laullon/anden-dcc/hardware/pico2w-reva/datasheets/README.md

# EXPERIMENT · local datasheet PDFs

English-language references only. The CH224 v1F English copy is retained;
a later Chinese revision is not included.

Downloaded 12 November 2026 for this experimental design. Documents retain
their original publishers' ownership and notices; the repository MIT license
does not relicense these PDFs. These are reference snapshots, not proof that
the candidate components or footprints are approved.

| PDF | Acquisition source |
| --- | --- |
| [Pico-2-W.pdf](Pico-2-W.pdf) | https://datasheets.raspberrypi.com/picow/pico-2-w-datasheet.pdf |
| [DRV8874.pdf](DRV8874.pdf) | https://www.ti.com/lit/ds/symlink/drv8874.pdf |
| [LMR51420.pdf](LMR51420.pdf) | https://www.ti.com/lit/ds/symlink/lmr51420.pdf |
| [CH224-v1F-EN.pdf](CH224-v1F-EN.pdf) | https://www.laskakit.cz/user/related_files/ch224ds1.pdf |
| [TPS3435.pdf](TPS3435.pdf) | https://www.ti.com/lit/ds/symlink/tps3435.pdf |
| [SN74LVC1G08.pdf](SN74LVC1G08.pdf) | https://www.ti.com/lit/ds/symlink/sn74lvc1g08.pdf |
| [PCA9306.pdf](PCA9306.pdf) | https://www.ti.com/lit/ds/symlink/pca9306.pdf |
| [USB4750-drawing.pdf](USB4750-drawing.pdf) | https://gct.co/files/drawings/usb4750.pdf |
| [TPS2663.pdf](TPS2663.pdf) | https://www.ti.com/lit/ds/symlink/tps2663.pdf |
| [SB560.pdf](SB560.pdf) | https://www.vishay.com/docs/88721/sb520.pdf |
| [1N5819.pdf](1N5819.pdf) | https://www.vishay.com/docs/88525/1n5817.pdf |

U1's KiCad Datasheet property uses `${KIPRJMOD}/../datasheets/CH224-v1F-EN.pdf`.
The schematic note names the same relative PDF. Open the `.kicad_pro` project
so KiCad resolves the project path. The review notes above link directly to files.
