laullon/anden-dcc/hardware/pico2w-reva/pinmap.csv

project_status | gpio | physical_pin | signal | direction | notes
EXPERIMENT_DESIGN_ONLY | 2 | 4 | DCC_PH | Output | PIO DCC waveform to DRV8874 PH
EXPERIMENT_DESIGN_ONLY | 3 | 5 | TRACK_EN_REQUEST | Output | PIO-aligned request through external watchdog gate
EXPERIMENT_DESIGN_ONLY | 4 | 6 | OLED_SDA | Bidirectional | I2C0. 3.3 V side of any required translator
EXPERIMENT_DESIGN_ONLY | 5 | 7 | OLED_SCL | Output | I2C0. 3.3 V side of any required translator
EXPERIMENT_DESIGN_ONLY | 6 | 9 | ENC_A | Input pull-up | Encoder contact to GND
EXPERIMENT_DESIGN_ONLY | 7 | 10 | ENC_B | Input pull-up | Encoder contact to GND
EXPERIMENT_DESIGN_ONLY | 8 | 11 | SELECT_N | Input pull-up | Encoder push button to GND
EXPERIMENT_DESIGN_ONLY | 9 | 12 | STOP_N | Input pull-up | Movement stop button to GND
EXPERIMENT_DESIGN_ONLY | 10 | 14 | MOVEMENT_LED | Output | Series resistor and LED to GND
EXPERIMENT_DESIGN_ONLY | 11 | 15 | DRIVER_FAULT_N | Input | 3.3 V pull-up on open-drain driver fault
EXPERIMENT_DESIGN_ONLY | 12 | 16 | WATCHDOG_HEARTBEAT | Output | Pulse only after application and DCC health checks
EXPERIMENT_DESIGN_ONLY | 13 | 17 | PD_PG_N | Input | 3.3 V pull-up on active-low PD PG
EXPERIMENT_DESIGN_ONLY | 14 | 19 | DRIVER_WAKE | Output | Driver nSLEEP with default-off pull-down
EXPERIMENT_DESIGN_ONLY | 15 | 20 | WATCHDOG_CONTROL | Output | Enable/re-arm semantics depend on final watchdog variant
EXPERIMENT_DESIGN_ONLY | 26 | 31 | RAIL_SENSE | ADC input | Divider filter and clamp values pending
EXPERIMENT_DESIGN_ONLY | 27 | 32 | CURRENT_SENSE | ADC input | Filtered protected IPROPI sense voltage
