laullon/anden-dcc/docs/hardware/connections.csv

source | destination | purpose
Uno USB | Uno and shield 5V logic | Bench or upload only; disconnect cab external 5 V first
PD +15V | MP1584 IN+ | Cab board step-down input
PD GND | MP1584 IN- | Common ground
MP1584 OUT+ 5.0V | ESP13 Arduino-side 5V header and OLED VCC | Verified regulated logic supply; disconnect before Uno USB
MP1584 OUT- | ESP13 Arduino-side GND header and OLED GND | Common ground
Uno D4 | Encoder A | Rotary input
Uno D5 | Encoder B | Rotary input
Uno D6 | Encoder switch contact | Select next on-diorama loco
Uno D2 | STOP switch contact | Stop movement
Uno GND | Encoder common and switch returns and STOP return | Contacts close to ground
Uno D7 | 470 ohm resistor then LED anode | Commanded movement indicator; LED cathode to GND
Uno A4 | OLED SDA | I2C data
Uno A5 | OLED SCL | I2C clock
PD +15V | Motor shield VIN terminal | Motor power; VIN CONNECT open
PD GND | Motor shield GND | Common ground
ESP13 TX via shield | Uno D0 RX | Checked UART request
Uno D1 TX | ESP13 RX via shield | Checked UART reply
Uno D3 | Motor shield enable A | Output enable
Uno D12 | Motor shield direction A | Routed DCC
Uno D9 | Motor shield brake A | Held LOW
Uno A0 | Motor shield sense A | Raw current sense
Uno D11 | Motor shield enable B | Held LOW
Uno D13 | Motor shield direction B | LED test only with outputs OFF
Uno D8 | Motor shield brake B | Held LOW
Uno A1 | Motor shield sense B | Telemetry
Motor A+ | Track 1 rail 1 and Track 2 rail 1 | DCC
Motor A- | Track 1 rail 2 and Track 2 rail 2 | DCC; neither rail is ground
