laullon/anden-dcc/assets/loco-types.png

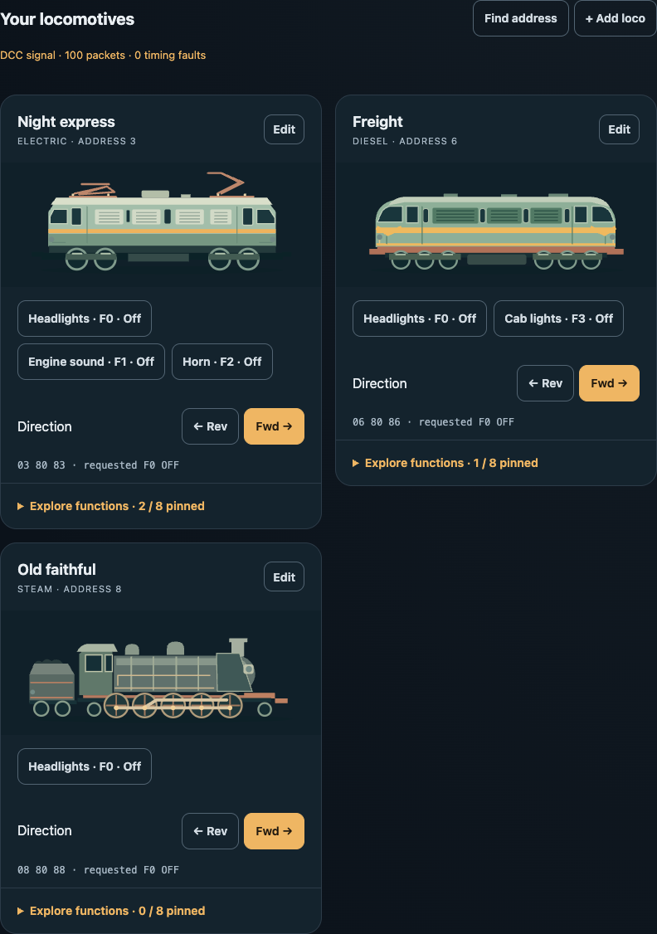
assets/loco-types.png
