laullon/anden-dcc/assets/ui-mobile.png

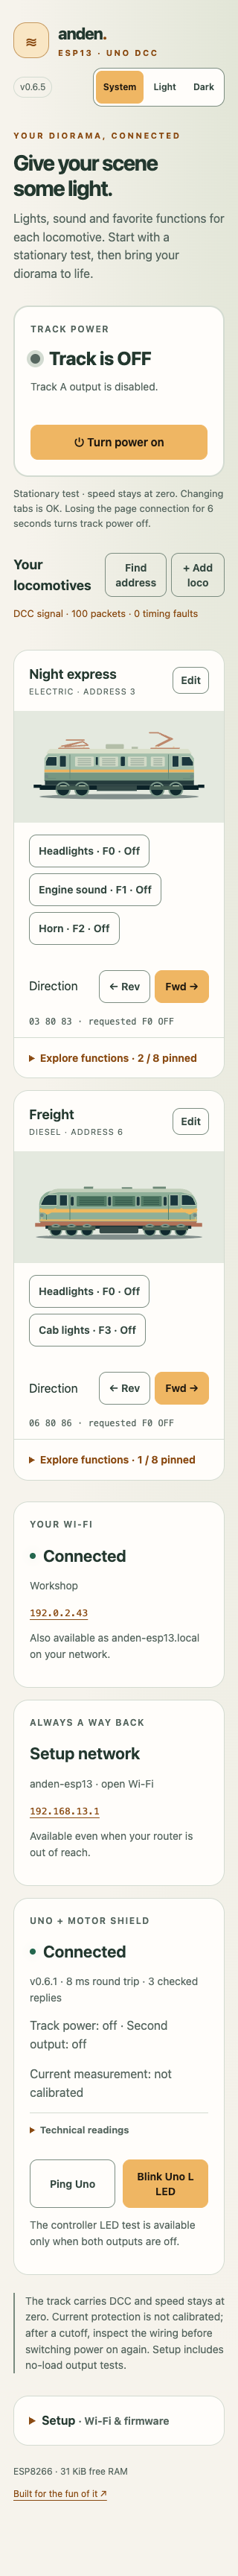
assets/ui-mobile.png
