laullon/anden-dcc/docs/VALIDATION.md

# Validation

The supported stack is Uno R3 / ATmega328P at 16 MHz, Deek-Robot L298P motor
shield and DOIT ESP13. Tested cores: AVR 1.8.7 and ESP8266 3.1.2.

## Minimal OLED layout · Uno 0.7.6

The Uno build and its native regression suite pass. The display now renders the
selected name in the yellow band, a four-times-size speed number and one rounded
speed gauge. Pixel tests check an empty gauge at zero, one-third/two-thirds/full
fills at steps 1–3, cleared speed-label margins, shorter-name clearing and the
no-selection state. The documentation preview uses captured production-driver
pixels.

The build uses 17,296 bytes of flash and 1,283 bytes of static RAM, leaving
765 bytes for stack/local variables. Uno 0.7.6 was uploaded and flash-verified
over USB. Checked UART replies confirmed the version, zero timing faults and
both output enables LOW. A temporary address-6 roster and label 1608 were
accepted at speed zero. The user confirmed that the OLED showed 1608, a large
zero and an empty rounded gauge. After both ESP UART switches were turned ON,
ESP13 0.7.4 reported Uno 0.7.6 online, DCC running, zero timing faults and
track output off. The user's saved roster selection resumed automatically.

## On-track control gating · ESP13 0.7.4 · 12 November 2026

The ESP build and all eight browser suites pass. Unmarked card tests verify
disabled function/direction buttons and disabled function-editor fields while
On track and Edit stay available with output off. Marking a loco re-enables
its supported controls; failed presence saves preserve the previous state.

ESP13 0.7.4 was installed by OTA with a verified reboot. A live browser confirmed
the renamed On track button, all off-track control restrictions and re-enabled
function/direction controls after marking a loco. The original selection was
restored. Track output remained off and Uno 0.7.5 reported zero timing faults.
The API/storage field remains onDiorama, preserving existing records.

## Direct card presence control · ESP13 0.7.3 · 12 November 2026

The ESP build and all eight browser suites pass. Roster tests cover toggling
presence directly from a card without opening the editor, saved pressed state,
failed-save recovery, output locks and 320 px layout.

ESP13 0.7.3 was installed by OTA after switching track output off. The initial
attempt while output was on was rejected by the existing update guard.
The reboot and version were verified. Live /locos/presence requests changed
and synchronized only the requested eligibility flag; extra stale name/address
fields were ignored and invalid presence values returned HTTP 400.
The original selection was restored. A live browser verified that both loco
cards show enabled On diorama buttons with track power off. Track output
remained off and Uno 0.7.5 reported zero timing faults.

## OLED / DCC timing correction · Uno 0.7.5 · 12 November 2026

After the named display update, the live Uno 0.7.4 reported one timing fault
during track mode and stopped DCC with both output enables LOW. Wire's
non-preemptible TWI ISR competes with the D12 mirror's fixed 20 µs phase.
The display transport was changed to poll the AVR TWI peripheral with TWIE
clear, allowing Timer1 to preempt OLED transfers. The existing DCC deadline
checks and fault shutdown are unchanged.

The native transport model verifies 400 kHz configuration, interrupt-free TWI
commands, ACK validation, invalid-input rejection and bounded START/STOP
timeouts. The display rendering and Uno/DCC regression suites pass.
Uno 0.7.5 builds to 17,420 bytes of flash and 1,307 bytes of static RAM
(741 bytes left for stack/local variables).

Uno 0.7.5 was uploaded and flash-verified. With USB logic power only, external
cab 5 V and motor power disconnected, track disconnected and ESP UART switches
OFF, a 120-second live UART test ran DCC while repeatedly changing display
labels and cycling output enable. It completed 132 label redraw requests,
21 output-enable cycles and 16,386 DCC packets with zero timing faults.
Both output enables were verified LOW afterward. The user confirmed that the
OLED still displayed correctly and reconnected both ESP UART switches.

A further six web power-on/heartbeat/power-off cycles exercised the complete
ESP13 0.7.2 to Uno 0.7.5 path with repeated OLED power-status redraws.
The final snapshot reported 47,615 DCC packets, zero timing faults and both
output enables LOW. All tests used USB logic power with motor power and track
disconnected; powered track operation still requires hardware validation.

## Named cab software · ESP13 0.7.2 / Uno 0.7.4

Both targets build. The native OLED harness checks full 64-row clearing,
bounded I²C transactions, complete redraws after name/speed/power changes,
shorter-name clearing and speed bar pixels. The label codec covers accented
names, uppercase conversion, truncation, empty names and unsupported UTF-8.
The Uno command harness checks malformed label rejection, eligible-address
binding, immediate name selection and cache clearing after roster changes.
The frame encoder also tests overlapping input/output buffers, used to save
Uno stack space while replying.

The OLED layout preview is rendered from the actual driver's captured I²C
data. On 12 November 2026, ESP13 0.7.2 was installed by OTA with a verified
reboot, and Uno 0.7.4 was uploaded and flash-verified over USB. The Uno reported
capability 4 and acknowledged the display label for address 6. The user
confirmed the actual OLED showed address 006, name 1608, the large zero-speed
readout and STOP.

With both UART switches ON, the ESP reported both firmware versions, online
name support and zero timing faults. Temporarily marking saved loco 1608
On diorama through /locos/save produced acknowledged CONTROLX and CABNAME
transactions and a ready roster without additional timeouts. Its original
presence setting was restored. Both output enables stayed LOW throughout.

Uno uses 19,028 bytes of flash and 1,523 bytes of static RAM, leaving 525 bytes
for stack/local variables. The STATE reply now uses one buffer in place to
reduce peak stack usage. Moving operation and the MP1584 cab supply still need
hardware validation. The earlier static display test is recorded below.

## SSD1315 cab display · 12 November 2026

Uno 0.7.3 was uploaded and flash-verified over USB. A checked UART reply
confirmed version 0.7.3. With motor/cab power and track disconnected, and
both ESP13 UART switches OFF, a CONTROLX snapshot selected address 3 at
zero speed. Both output enables remained LOW. The user confirmed
`A 003` in the yellow band and `S 00` in the blue region of the 0.96-inch
128×64 SSD1315 display.

This verifies static display output with USB logic power. Display updates
during movement, encoder/STOP wiring and MP1584 cab power still need hardware
checks. The ESP13 was observed running 0.6.4; filtered cab selection requires
ESP13 0.7.1.

## Software checks

- Build both boards with `tools/build.sh`; generated ESP assets are checked.
- Native tests cover checked UART frames, corruption/noise, maximum masks,
  F0–F28 packet groups/XOR, zero speed, independent loco state, atomic publication,
  address search, favorite records, LED feedback and browser/output leases.
- Timer1 register modeling checks D12 phase, delayed interrupt entry,
  packet-boundary enable, default-off, backup timeout and late-edge fail-off.
  Modeling does not measure execution time on the AVR.
- Browser checks cover power transitions, scroll-visible power controls, held
  mouse targets during polling, function favorites/drafts, direction, finder,
  themes, setup/OTA, offline behavior and 320 px layouts.

## Encoder cab · ESP13 / Uno 0.7.0

Both targets build and all eight browser suites pass. The Uno command harness
exercises encoder speed changes, stop and long-press selection, the motion
limit, schedule changes and power loss. The Timer1 model decodes the priority
speed/stop packets and checks that the interrupt guard cuts power even when
ordinary KEEP messages continue.

Uno uses 17,046 bytes of flash and 1,311 bytes of static RAM. The ESP image is
411,792 bytes. The OLED and stopping distances remain to be checked on hardware.
See the [cab wiring and first check](../firmware/uno-stack-test/CAB.md).

## Build snapshot at `e138437`

The comment update regenerated the embedded web page. Both targets built and
all eight browser suites passed. ESP13 0.6.5 built to 411,776 bytes with 34,204
bytes static RAM. Uno 0.6.1 used 12,588 bytes flash and 1,018 bytes static RAM.
For later builds, check the ESP manifest and the Uno compiler output.

## Full review · ESP13 0.6.5 / Uno 0.6.1, 6 November 2026

Both firmware targets compile and all eight browser suites pass. New regressions
exercise the actual Uno command parser, scheduler/ISR, streaming image validator,
HTTP update lifecycle and filesystem initialization policy. Buffer-bound and
filesystem tests also run with AddressSanitizer/UndefinedBehaviorSanitizer.
Tests reproduce the original buffer overflow, signature collision, command
readiness mutation, finder clock jumps and corrupt-image upload acceptance.

Uno: 12,588 bytes flash / 1,018 bytes static RAM. ESP: 411,360-byte image /
34,204 bytes static RAM. The validated image remains below the 448 KiB OTA limit.
The review does not install firmware or perform new loaded or timing measurements.
See [confirmed findings and regression mapping](CODE-REVIEW.md).

## Uniform function controls 0.6.4, 6 November 2026

All eight browser suites pass with a permanent single F0 toggle and the same
control for F1–F28, including power-off presets. Live ESP 0.6.4 checks toggled F0
and F28 both ways while A/B stayed disabled, restored the original function states,
and preserved loco/favorite metadata. No power-on request was sent; no JavaScript
or timing faults were observed. Uno 0.6.0 is unchanged. ESP image: 414,176 bytes.

## UI reliability review 0.6.2, 6 November 2026

Eight browser suites pass, including new regressions for timeouts, conflicting
requests, stale power snapshots, delayed save completion, clipped mobile buttons,
keyboard focus clearance and an editor whose connection/output/storage state
changes while open. These reproduced failures in the earlier page.

ESP image: 414,000 bytes. Live OTA verified 0.6.2; saved loco/favorite metadata
survived. A fresh live page preserved drafts/focus through polling, guarded the
open editor during a simulated lost connection and recovered without losing the
draft. Compact power stayed OFF; the live browser check sent no POSTs and found
no JavaScript/timing faults. The Uno firmware/DCC generator is unchanged. See the
[review findings and test mapping](UI-REVIEW.md). Mocked delay/failure tests do
not activate hardware.

## UI/project release 0.6.1, 6 November 2026

Both supported sketches compile from firmware/. All six browser suites pass.
ESP image: 413,280 bytes. Live OTA verified 0.6.1; the original loco metadata and
favorite survived. On the installed page, compact power remains visible through
scrolling/polling and hands back to the main panel at the top, with no JavaScript
or timing faults. Output was left OFF. Uno 0.6.0 did not need a reflash.

## Hardware observations, 6 November 2026

With motor VIN and track disconnected, installed Uno 0.6.0 passed all 29 function
bits by snapshot CRC, full eight-loco masks and 126 active update/KEEP pairs over
eight seconds with zero timing faults. The expiry test disabled A; a late KEEP
did not restart it. The complete HTTP → ESP → Uno path switched every bit ON and
OFF without changing the other loco, with zero timing faults. B stayed disabled.

A temporary named favorite survived actual ESP OTA; requested functions restarted
OFF and original names/addresses/types survived. The temporary favorite was
removed. The final output and all function bits were OFF.

Uno 0.6.0: 12,812 bytes flash and 1,018 bytes static RAM. ESP 0.6.0 image:
412,688 bytes. See build output for the current UI release's size.

Earlier no-load bridge tests measured +15 V and −15 V in the DC polarity tests.
DCC was observed on an oscilloscope around 30 V peak-to-peak with a 15 V supply.
Logic captures at 500 kS/s decoded zero-speed/direction/search packets with valid
XOR. That sample rate has 2 µs resolution; it does not establish sub-microsecond
pulse accuracy. New function-group physical pulse widths were not measured in
the 0.6.0 validation.

## Remaining limits

Actual decoder function mappings, current-sense calibration, loaded short-circuit
handling, thermal limits and long-running powered operation remain unverified.
The raw A0 cutoff is not proven protection. Do not describe successful software
checks as proof of electrical safety or loaded performance. Keep motor VIN and
track disconnected during uploads and firmware diagnostics.
