laullon/anden-dcc/docs/hardware/schematic.pdf

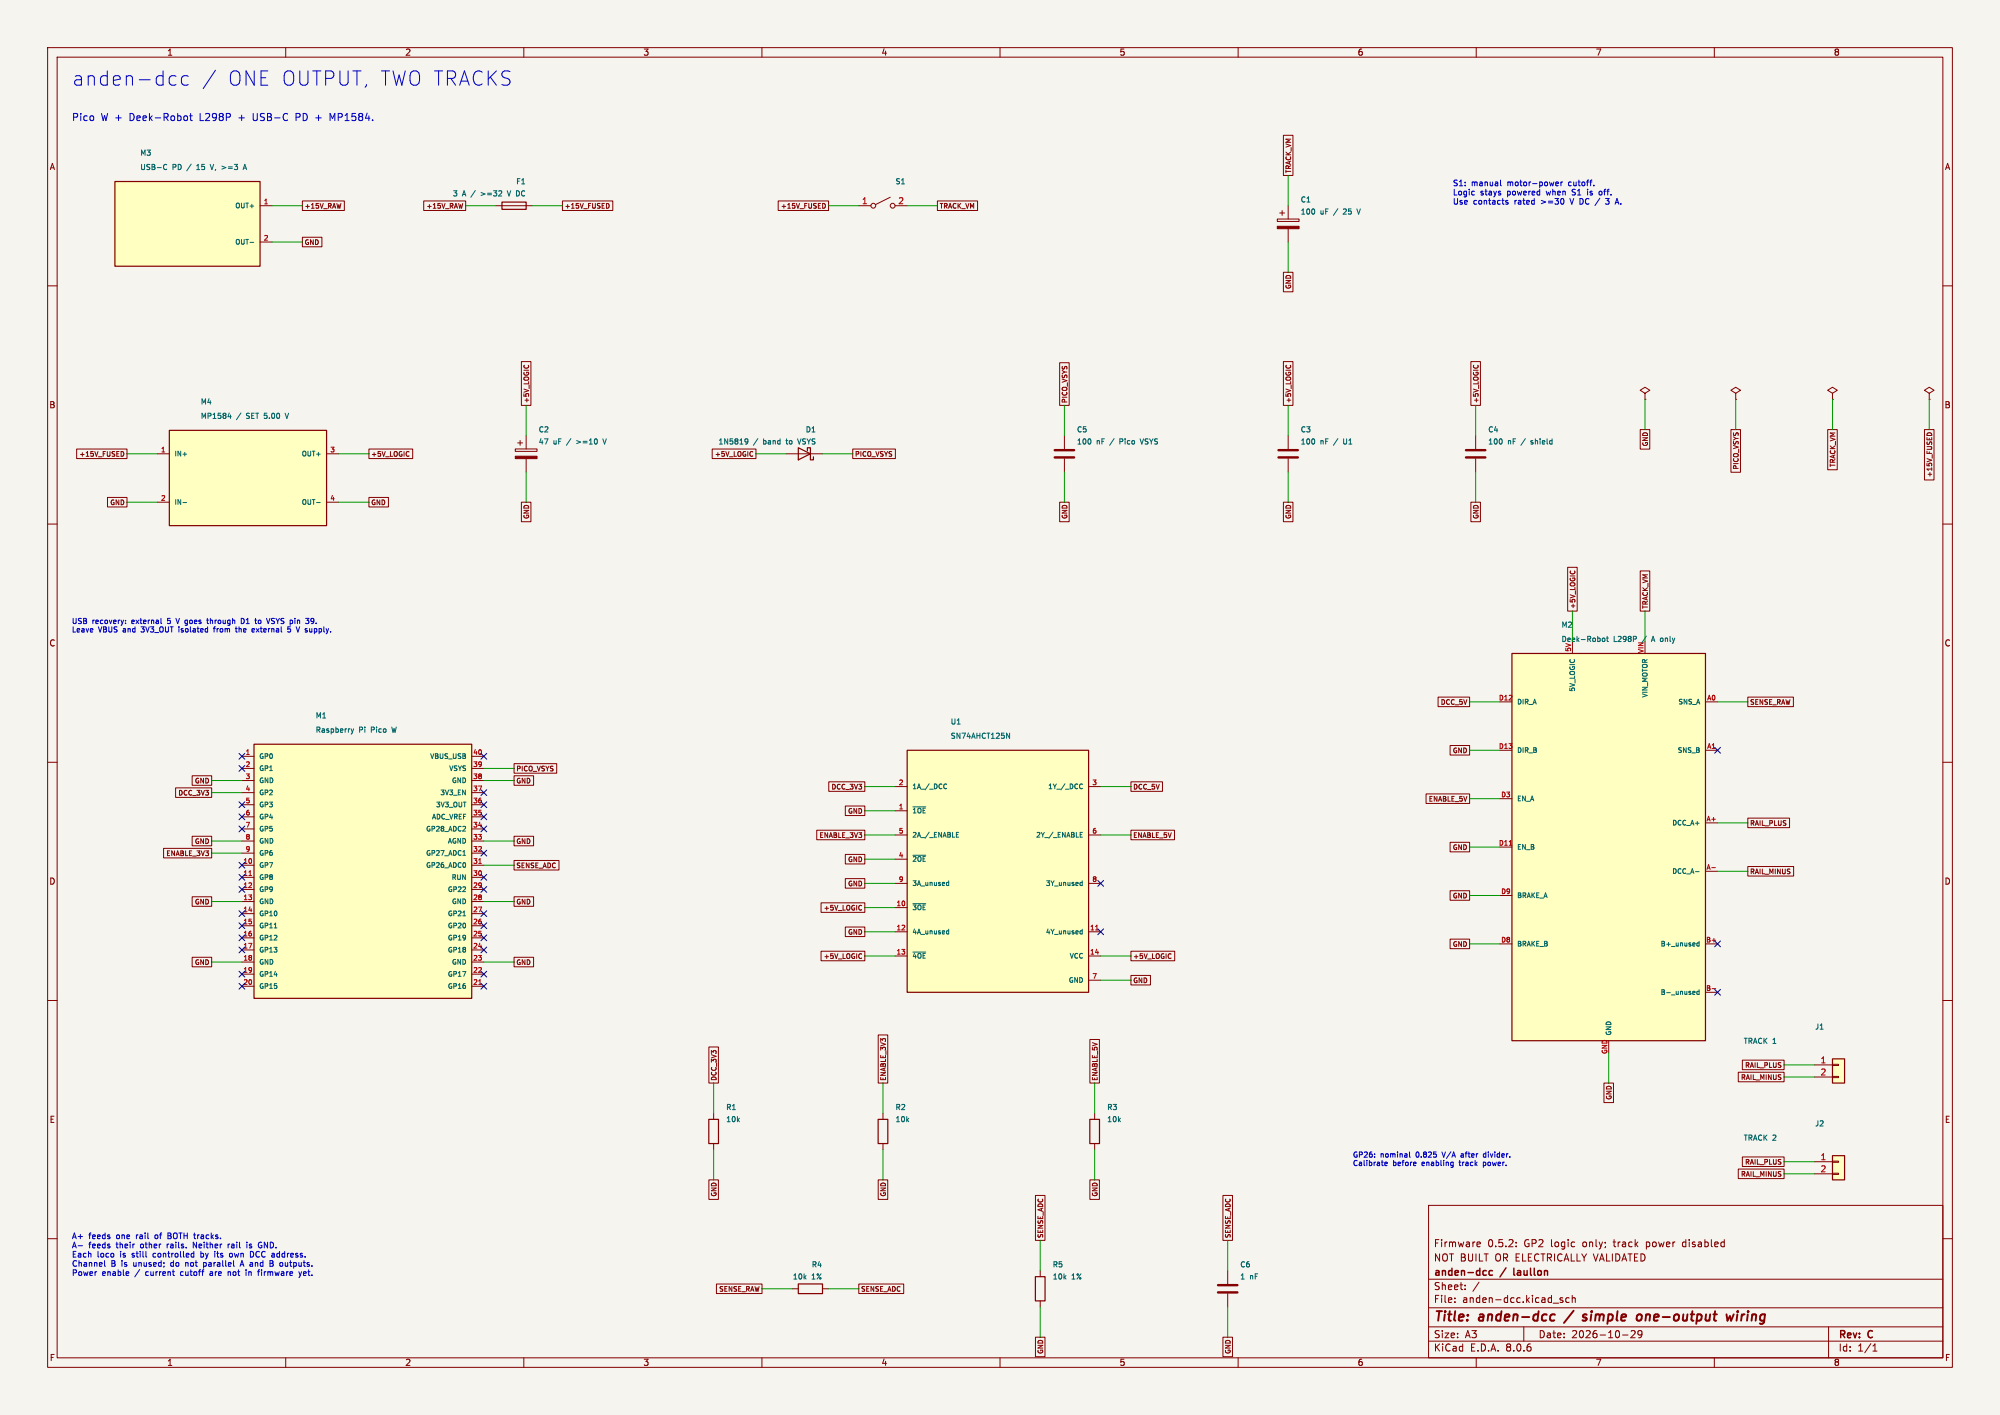
[picture p7: page 1]
