laullon/anden-dcc/hardware/pico2w-reva/kicad/01b-power-entry.kicad_sch

## KiCad design hardware/pico2w-reva/kicad/01b-power-entry.kicad_sch (2026-11-12)

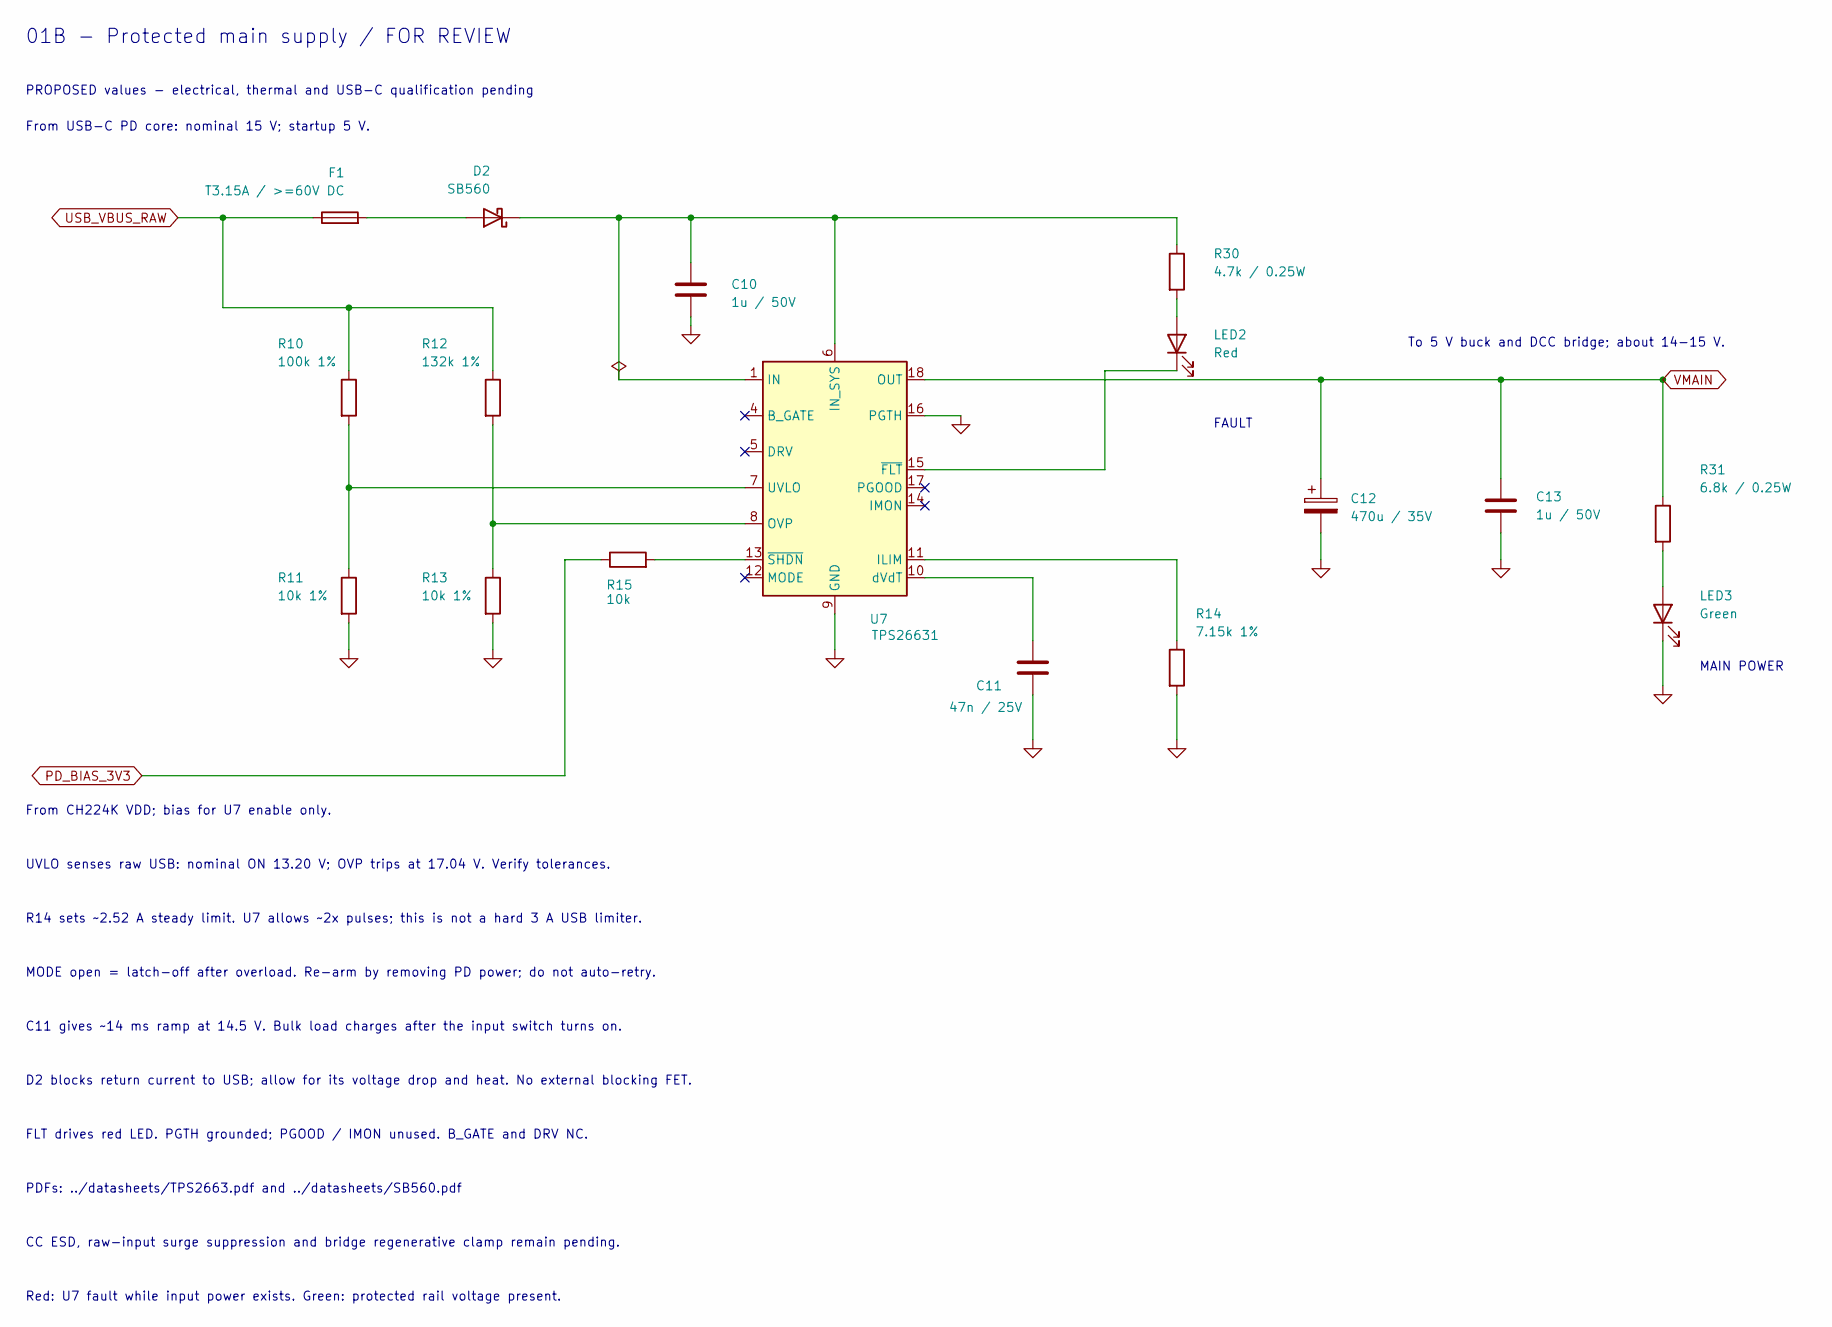
[picture p8: schematic 01b-power-entry.kicad_sch]

Parts:
C10, C13: 1u / 50V
C11: 47n / 25V
C12: 470u / 35V
D2: SB560
F1: T3.15A / >=60V DC
LED2: Red
LED3: Green
R10: 100k 1%
R11, R13: 10k 1%
R12: 132k 1%
R14: 7.15k 1%
R15: 10k
R30: 4.7k / 0.25W
R31: 6.8k / 0.25W
U7: TPS26631

Connections:
GND: C10.2, C11.2, C12.2, C13.2, LED3.1 (K), R11.2, R13.2, R14.2, U7.9 (GND), U7.16 (PGTH), U7.21 (GND)
unnamed: C10.1, D2.1 (K), R30.1, U7.1 (IN), U7.2 (IN), U7.3 (IN), U7.6 (IN_SYS)
unnamed: C11.1, U7.10 (dVdT)
unnamed: D2.2 (A), F1.2
unnamed: LED2.1 (K), U7.15 (~FLT)
unnamed: LED2.2 (A), R30.2
unnamed: LED3.2 (A), R31.2
unnamed: R10.2, R11.1, U7.7 (UVLO)
unnamed: R12.2, R13.1, U7.8 (OVP)
unnamed: R14.1, U7.11 (ILIM)
unnamed: R15.2, U7.13 (~SHDN)
PD_BIAS_3V3: R15.1
USB_VBUS_RAW: F1.1, R10.1, R12.1
VMAIN: C12.1, C13.1, R31.1, U7.18 (OUT), U7.19 (OUT), U7.20 (OUT)

Notes on the sheet:
FAULT
D2 blocks return current to USB; allow for its voltage drop and heat. No external blocking FET.
PROPOSED values - electrical, thermal and USB-C qualification pending
01B - Protected main supply / FOR REVIEW
From USB-C PD core: nominal 15 V; startup 5 V.
From CH224K VDD; bias for U7 enable only.
C11 gives ~14 ms ramp at 14.5 V. Bulk load charges after the input switch turns on.
MODE open = latch-off after overload. Re-arm by removing PD power; do not auto-retry.
CC ESD, raw-input surge suppression and bridge regenerative clamp remain pending.
PDFs: ../datasheets/TPS2663.pdf and ../datasheets/SB560.pdf
R14 sets ~2.52 A steady limit. U7 allows ~2x pulses; this is not a hard 3 A USB limiter.
To 5 V buck and DCC bridge; about 14-15 V.
Red: U7 fault while input power exists. Green: protected rail voltage present.
MAIN POWER
UVLO senses raw USB: nominal ON 13.20 V; OVP trips at 17.04 V. Verify tolerances.
FLT drives red LED. PGTH grounded; PGOOD / IMON unused. B_GATE and DRV NC.
