laullon/anden-dcc/hardware/kicad/anden-dcc.kicad_sch

## KiCad design hardware/kicad/anden-dcc.kicad_sch (2026-10-29)

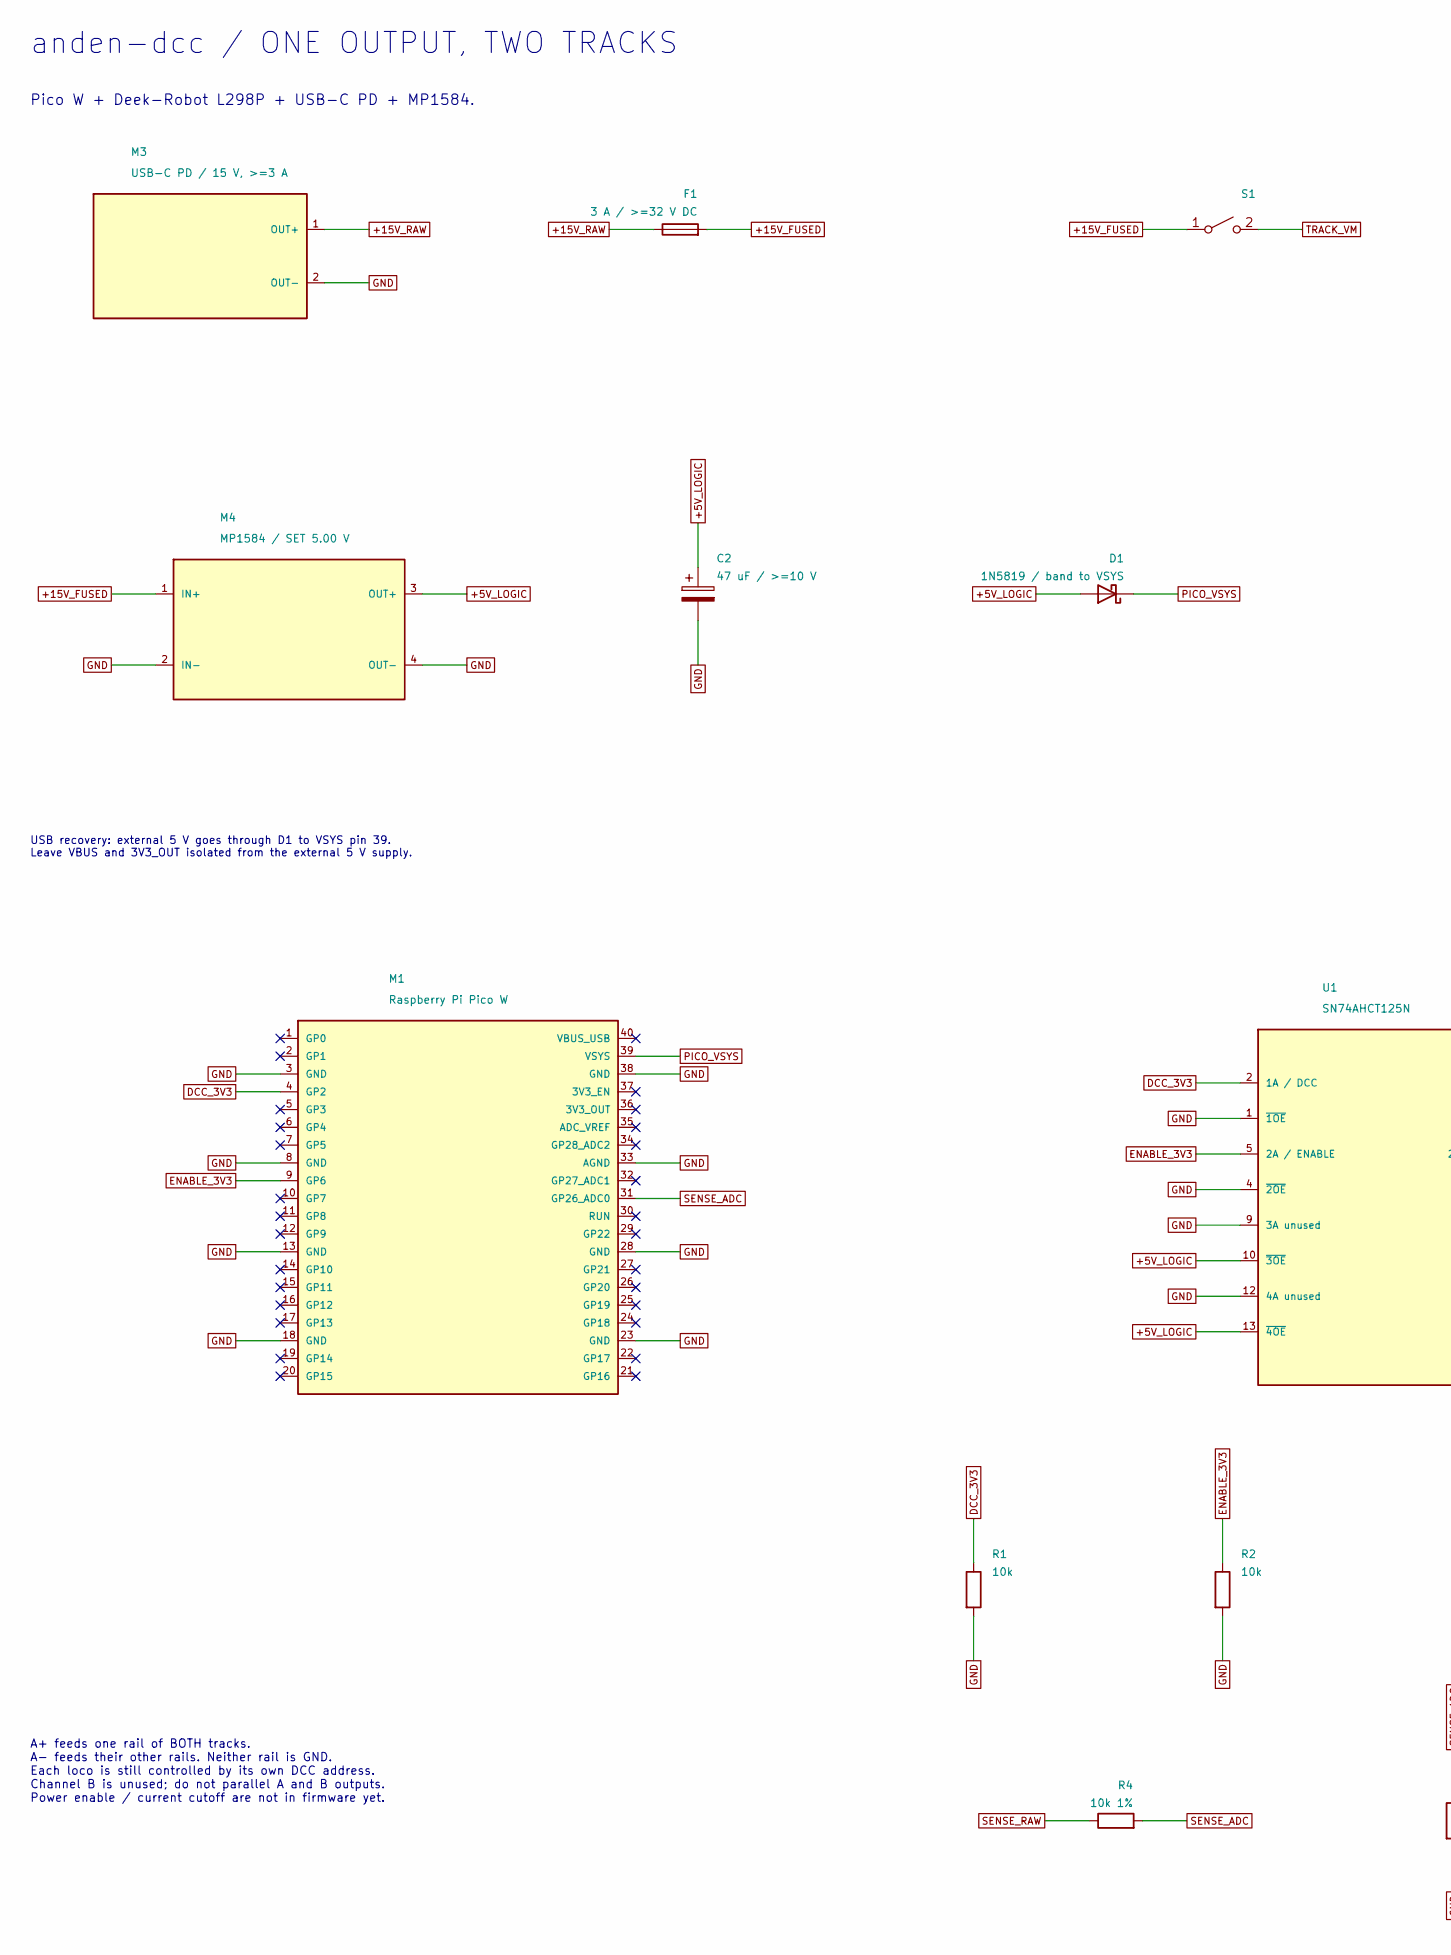
[picture p9: schematic anden-dcc.kicad_sch, part in row 1, column 1]

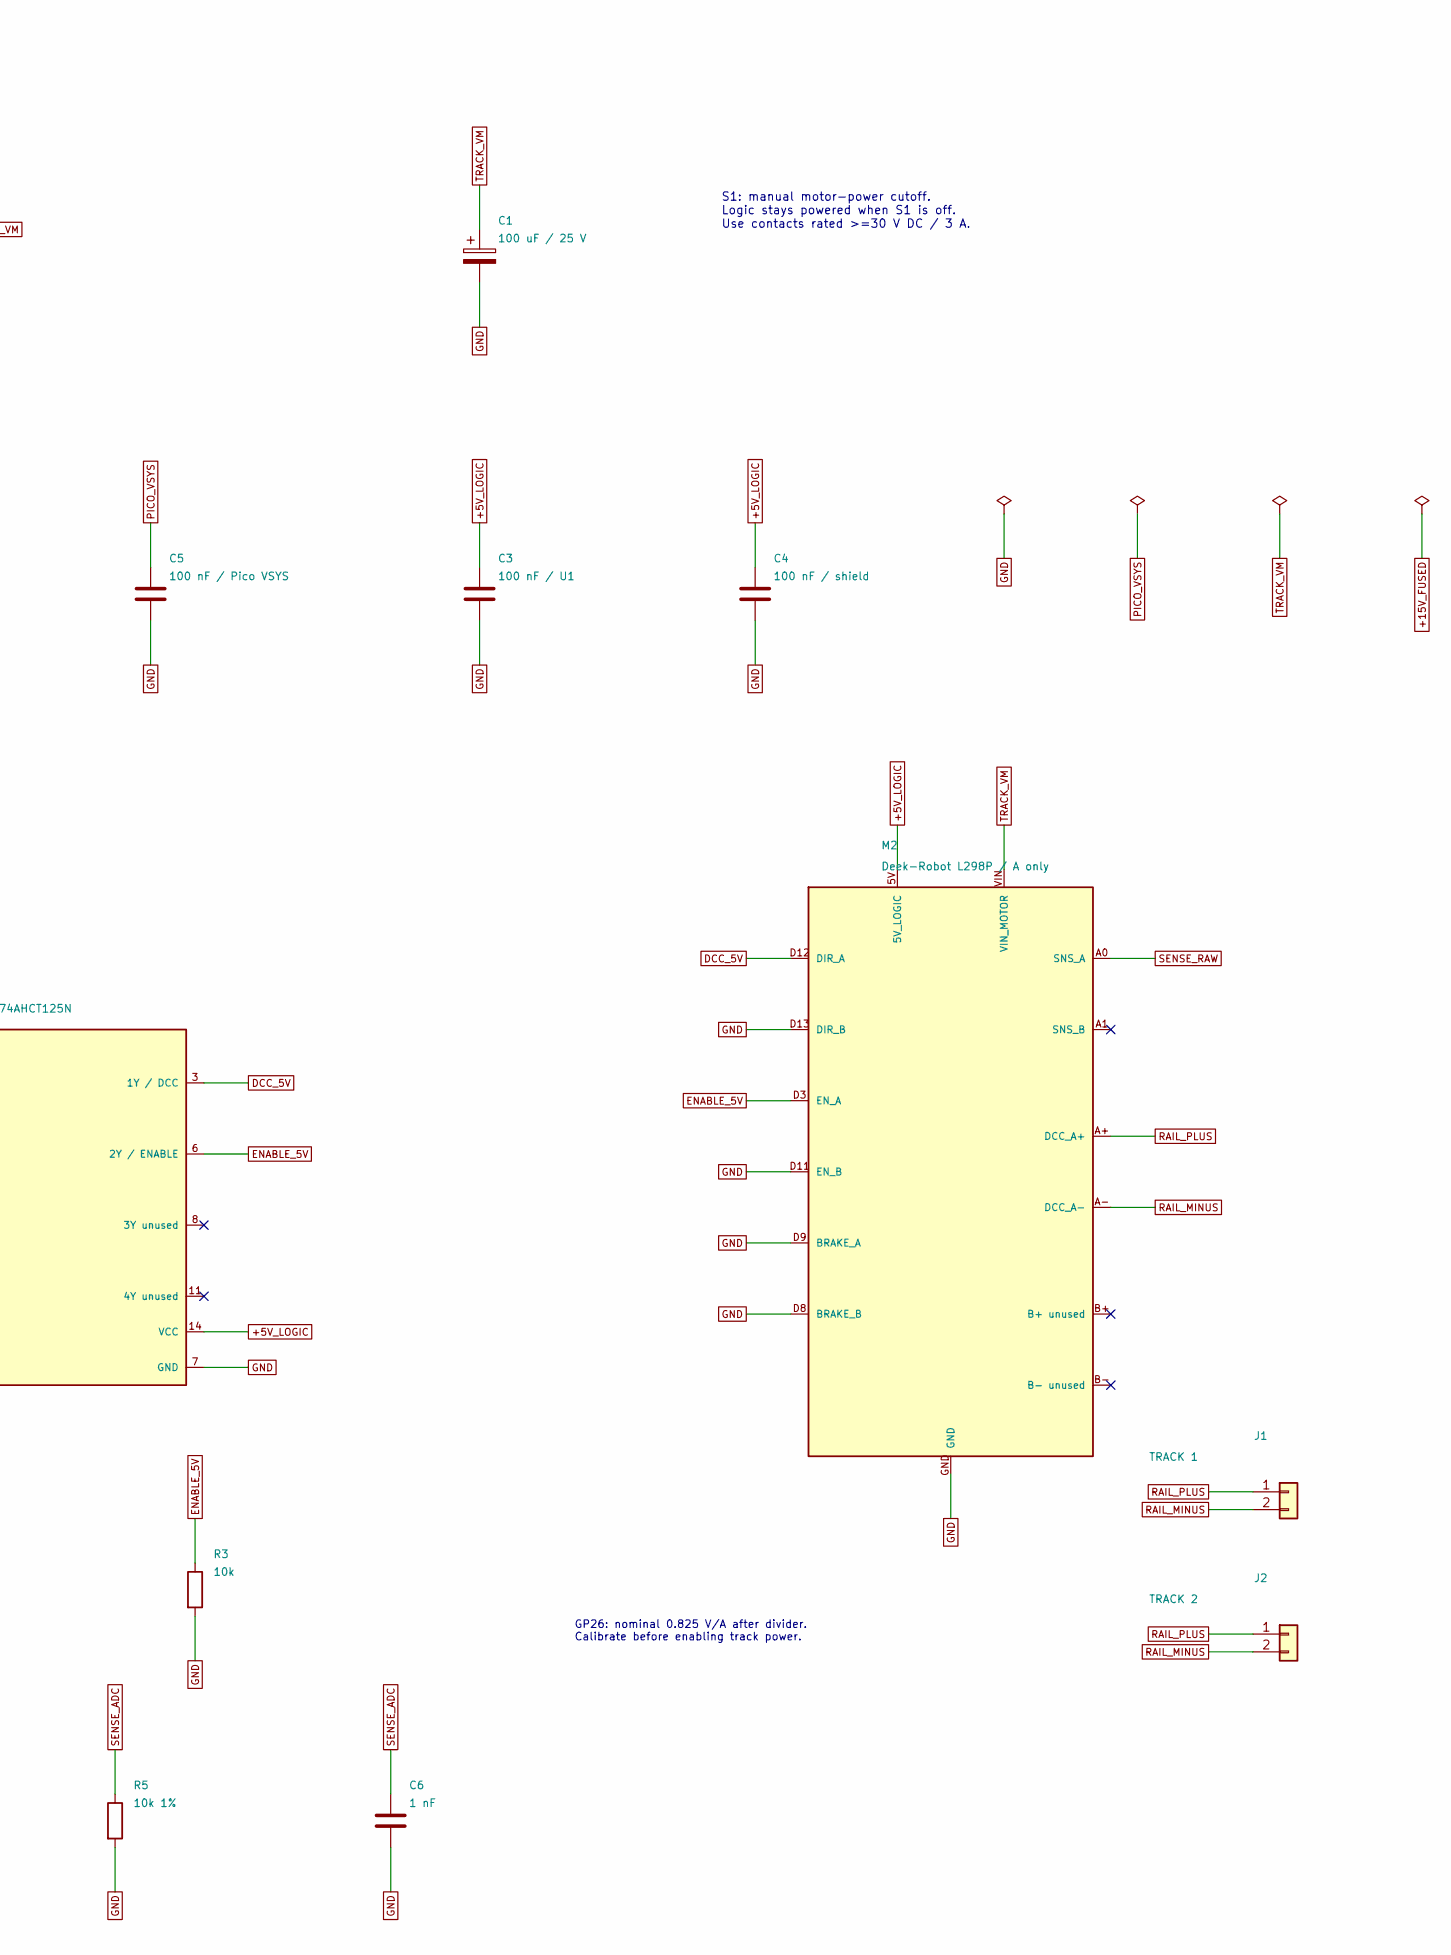
[picture p10: schematic anden-dcc.kicad_sch, part in row 1, column 2]

Parts:
C1: 100 uF / 25 V
C2: 47 uF / >=10 V
C3: 100 nF / U1
C4: 100 nF / shield
C5: 100 nF / Pico VSYS
C6: 1 nF
D1: 1N5819 / band to VSYS
F1: 3 A / >=32 V DC
J1: TRACK 1
J2: TRACK 2
M1: Raspberry Pi Pico W
M2: Deek-Robot L298P / A only
M3: USB-C PD / 15 V, >=3 A
M4: MP1584 / SET 5.00 V
R1, R2, R3: 10k
R4, R5: 10k 1%
S1: TRACK POWER / OFF
U1: SN74AHCT125N

Connections:
+5V_LOGIC: C2.1, C3.1, C4.1, D1.2 (A), M2.5V (5V_LOGIC), M4.3 (OUT+), U1.10 (~3OE), U1.13 (~4OE), U1.14 (VCC)
+15V_FUSED: F1.2, M4.1 (IN+), S1.1 (A)
+15V_RAW: F1.1, M3.1 (OUT+)
DCC_3V3: M1.4 (GP2), R1.1, U1.2 (1A / DCC)
DCC_5V: M2.D12 (DIR_A), U1.3 (1Y / DCC)
ENABLE_3V3: M1.9 (GP6), R2.1, U1.5 (2A / ENABLE)
ENABLE_5V: M2.D3 (EN_A), R3.1, U1.6 (2Y / ENABLE)
GND: C1.2, C2.2, C3.2, C4.2, C5.2, C6.2, M1.3 (GND), M1.8 (GND), M1.13 (GND), M1.18 (GND), M1.23 (GND), M1.28 (GND), M1.33 (AGND), M1.38 (GND), M2.D8 (BRAKE_B), M2.D9 (BRAKE_A), M2.D11 (EN_B), M2.D13 (DIR_B), M2.GND, M3.2 (OUT-), M4.2 (IN-), M4.4 (OUT-), R1.2, R2.2, R3.2, R5.2, U1.1 (~1OE), U1.4 (~2OE), U1.7 (GND), U1.9 (3A unused), U1.12 (4A unused)
PICO_VSYS: C5.1, D1.1 (K), M1.39 (VSYS)
RAIL_MINUS: J1.2, J2.2, M2.A- (DCC_A-)
RAIL_PLUS: J1.1, J2.1, M2.A+ (DCC_A+)
SENSE_ADC: C6.1, M1.31 (GP26_ADC0), R4.2, R5.1
SENSE_RAW: M2.A0 (SNS_A), R4.1
TRACK_VM: C1.1, M2.VIN (VIN_MOTOR), S1.2 (B)

Notes on the sheet:
anden-dcc / ONE OUTPUT, TWO TRACKS
Pico W + Deek-Robot L298P + USB-C PD + MP1584.
S1: manual motor-power cutoff. Logic stays powered when S1 is off. Use contacts rated >=30 V DC / 3 A.
GP26: nominal 0.825 V/A after divider. Calibrate before enabling track power.
A+ feeds one rail of BOTH tracks. A- feeds their other rails. Neither rail is GND. Each loco is still controlled by its own DCC address. Channel B is unused; do not parallel A and B outputs. Power enable / current cutoff are not in firmware yet.
USB recovery: external 5 V goes through D1 to VSYS pin 39. Leave VBUS and 3V3_OUT isolated from the external 5 V supply.
