laullon/anden-dcc/firmware/anden-dcc/anden-dcc.ino

#include <WiFi.h>
#include <WebServer.h>
#include <HTTPUpdateServer.h>
#include <LittleFS.h>
#include <SimpleMDNS.h>
#include <lwip_wrap.h>
#include "DccSignal.h"
#include "DccPacket.h"
#include "WebAssets.h"

// Arduino-Pico 6.3.1, Pico W, flash: 1 MB application + 1 MB LittleFS.
// Logic-analyzer prototype: GP2 carries DCC; no power-stage pins are assigned.
const char* AP_NAME = "anden-dcc";
const char* VERSION = "0.6.2";
WebServer server(80);
HTTPUpdateServer updater;
String networkName, networkPassword;
LocoRoster roster;
AddressFinder finder;
bool storageReady = false, connectPending = false;
bool accessPointRunning = false;
bool mdnsReady = false;
bool wasConnected = false;
bool ledOn = true;
uint32_t lastAttempt = 0;
uint32_t mdnsAttempt = 0;
bool webActivity = false;
uint32_t lastWebActivity = 0;
constexpr uint32_t WEB_BLINK_MS = 120;

void signalWebActivity() {
  webActivity = true;
  lastWebActivity = millis();
  // Switch immediately, even if sending the response takes a while.
  ledOn = false;
  digitalWrite(LED_BUILTIN, LOW);
}

void stopMdns() {
  if (!mdnsReady) return;
  LWIPMutex networkLock;
  MDNS.end();
  mdnsReady = false;
}

void startMdns() {
  // Start only with the STA interface active and DHCP complete. Protect the
  // whole interface traversal as well as the individual wrapped lwIP calls.
  LWIPMutex networkLock;
  mdnsReady = MDNS.begin(AP_NAME);
  if (mdnsReady) MDNS.addService("http", "tcp", 80);
}

String jsonString(const String& value) {
  String result = "\"";
  for (size_t i = 0; i < value.length(); ++i) {
    unsigned char c = value[i];
    if (c == '"' || c == '\\') { result += '\\'; result += char(c); }
    else if (c < 32) {
      char escaped[7];
      snprintf(escaped, sizeof(escaped), "\\u%04x", c);
      result += escaped;
    } else result += char(c);
  }
  return result + "\"";
}

bool saveNetwork(const String& ssid, const String& password) {
  if (!storageReady) return false;
  File file = LittleFS.open("/wifi.tmp", "w");
  if (!file) return false;
  size_t expected = ssid.length() + password.length() + 2;
  size_t written = file.print(ssid + "\n" + password + "\n");
  file.close();
  if (written != expected) { LittleFS.remove("/wifi.tmp"); return false; }
  return LittleFS.rename("/wifi.tmp", "/wifi.cfg");
}

void loadNetwork() {
  if (!storageReady) return;
  File file = LittleFS.open("/wifi.cfg", "r");
  if (!file) return;
  if (file.size() > 98) { file.close(); return; }
  String ssid = file.readStringUntil('\n');
  String password = file.readStringUntil('\n');
  file.close();
  if (ssid.length() > 0 && ssid.length() <= 32 && password.length() <= 63) {
    networkName = ssid;
    networkPassword = password;
    connectPending = true;
  }
}

void printStatus() {
  Serial.printf("anden-dcc v%s; DCC GPIO2; track power disabled; AP=%s; mDNS=%s; ", VERSION,
                accessPointRunning ? "192.168.42.1" : "off", mdnsReady ? "ready" : "off");
  Serial.printf("storage=%s; configured=%s; ", storageReady ? "ready" : "error", networkName.length() ? "yes" : "no");
  if (WiFi.status() == WL_CONNECTED && WiFi.localIP().isSet()) {
    Serial.print("LAN http://"); Serial.println(WiFi.localIP());
  } else Serial.println("LAN not connected");
}


int number(const String& value, int maximum) {
  if (!value.length() || value.length() > 3) return -1;
  for (size_t i = 0; i < value.length(); ++i)
    if (value[i] < '0' || value[i] > '9') return -1;
  int result = value.toInt();
  return result >= 1 && result <= maximum ? result : -1;
}

void loadRoster() {
  // Default two display slots; neither presumes your actual decoder address.
  roster.save(0, 3, "");
  roster.save(0, 4, "");
  if (!storageReady || !LittleFS.exists("/locos.cfg")) return;
  File file = LittleFS.open("/locos.cfg", "r");
  if (!file || file.size() > 1024) return;
  String header=file.readStringUntil('\n');
  bool legacy=header=="anden-roster-1";
  if(!legacy && header!="anden-roster-2") return;
  LocoRoster loaded;
  while (file.available()) {
    String line=file.readStringUntil('\n');
    if(!loaded.loadRecord(line.c_str(),legacy))return;
  }
  roster = loaded; // A valid empty roster is intentional.
}

bool saveRoster(const LocoRoster& value) {
  if (!storageReady) return false;
  File file = LittleFS.open("/locos.tmp", "w");
  if (!file) return false;
  String data = "anden-roster-2\n";
  for (uint8_t i = 0; i < value.count; ++i) {
    const auto& loco = value.entries[i];
    data += String(loco.id) + "\t" + String(loco.address) + "\t" + LocoRoster::typeName(loco.type) + "\t" + loco.name + "\n";
  }
  bool ok = file.print(data) == data.length();
  file.close();
  if (ok) ok = LittleFS.rename("/locos.tmp", "/locos.cfg");
  if (!ok) LittleFS.remove("/locos.tmp");
  return ok;
}

String finderStatus() {
  return "{\"stage\":" + jsonString(finder.name()) + ",\"active\":" +
      (finder.active()?"true":"false") + ",\"step\":" + String(finder.step) +
      ",\"first\":" + String(finder.first) + ",\"last\":" + String(finder.last) +
      ",\"low\":" + String(finder.low) + ",\"high\":" + String(finder.high) +
      ",\"middle\":" + String(finder.middle()) + ",\"result\":" + String(finder.result) +
      ",\"waitMs\":" + String(finder.wait(millis())) + "}";
}

void serviceFinder() {
  bool wasActive=finder.active();
  if(finder.tick(millis())) DccSignal::setFinder(finder);
  if(wasActive && !finder.active()) DccSignal::setRoster(roster,true);
}

bool finderLocked() {
  serviceFinder();
  if(!finder.active()) return false;
  server.send(409,"text/plain","Finish or cancel the address search first.");
  return true;
}

String dccStatus() {
  String body = "{\"ready\":";
  body += DccSignal::ready() ? "true" : "false";
  body += ",\"running\":"; body += DccSignal::running() ? "true" : "false";
  body += ",\"pin\":2,\"maxLocos\":8,\"locos\":[";
  for (uint8_t i = 0; i < roster.count; ++i) {
    const auto& loco = roster.entries[i];
    char bytes[9];
    snprintf(bytes, sizeof(bytes), "%02X %02X %02X", loco.address,
        DccPacket::instruction(loco.f0), DccPacket::checksum(loco.address, loco.f0));
    if (i) body += ',';
    body += "{\"id\":" + String(loco.id) + ",\"name\":" + jsonString(loco.name);
    body += ",\"type\":" + jsonString(LocoRoster::typeName(loco.type));
    body += ",\"address\":" + String(loco.address) + ",\"f0\":";
    body += loco.f0 ? "true" : "false";
    body += ",\"bytes\":" + jsonString(bytes) + "}";
  }
  return body + "],\"finder\":" + finderStatus() + "}";
}

void setup() {
  Serial.begin(115200);
  pinMode(LED_BUILTIN, OUTPUT);
  digitalWrite(LED_BUILTIN, HIGH);
  // Do not auto-format: a mount failure must not erase saved credentials.
  LittleFSConfig fsConfig;
  fsConfig.setAutoFormat(false);
  LittleFS.setConfig(fsConfig);
  storageReady = LittleFS.begin();
  // A virgin device has no filesystem. Format only if the reserved region is erased.
  if (!storageReady) {
    extern uint8_t _FS_start;
    const uint8_t* flash = &_FS_start;
    bool erased = true;
    for (size_t i = 0; i < 4096; ++i) if (flash[i] != 0xff) { erased = false; break; }
    if (erased && LittleFS.format()) storageReady = LittleFS.begin();
  }
  // The core leaves the applied OTA image in LittleFS. Reclaim it after boot
  // so the next upload measures free space without counting the old image.
  if(storageReady) LittleFS.remove("/firmware.bin");
  loadNetwork();
  loadRoster();
  WiFi.mode(WIFI_AP_STA);
  WiFi.softAPConfig(IPAddress(192,168,42,1), IPAddress(192,168,42,1), IPAddress(255,255,255,0));
  if (!WiFi.softAP(AP_NAME)) while (true) delay(1000);
  accessPointRunning = true;
  DccSignal::begin(roster);
  server.addHook([](const String& method, const String& url, WiFiClient*, HTTPServer::ContentTypeFunction) {
    const String path = url.indexOf('?') >= 0 ? url.substring(0,url.indexOf('?')) : url;
    // Background status refreshes should not look like user activity.
    bool statusPoll = method == "GET" && path == "/api/status";
    if (!statusPoll) signalWebActivity();
    if (method == "POST" && (path == "/update" || path == "/wifi/save" || path == "/wifi/forget") && finderLocked())
      return HTTPServer::CLIENT_REQUEST_IS_HANDLED;
    if (method == "POST" && path == "/update") {
      DccSignal::stop();
      // Also reclaim partial files left by a failed upload in this boot.
      if(storageReady && LittleFS.exists("/firmware.bin") && !LittleFS.remove("/firmware.bin")) {
        server.send(500,"text/plain","Could not reclaim OTA staging space.");
        return HTTPServer::CLIENT_REQUEST_IS_HANDLED;
      }
    }
    return HTTPServer::CLIENT_REQUEST_CAN_CONTINUE;
  });
  server.on("/", HTTP_GET, []() { server.send(200, "text/html; charset=utf-8", PAGE); });
  server.on("/icon.svg", HTTP_GET, []() {
    server.sendHeader("Cache-Control", "public, max-age=86400");
    server.send(200, "image/svg+xml", ICON_SVG);
  });
  server.on("/favicon.svg", HTTP_GET, []() {
    server.sendHeader("Cache-Control", "public, max-age=86400");
    server.send(200, "image/svg+xml", FAVICON_SVG);
  });
  server.on("/favicon.ico", HTTP_GET, []() {
    server.sendHeader("Cache-Control", "public, max-age=86400");
    server.send(200, "image/x-icon", reinterpret_cast<const char*>(FAVICON_ICO), sizeof(FAVICON_ICO));
  });
  server.on("/update", HTTP_GET, []() {
    server.sendHeader("Location", "/?setup=firmware");
    server.send(303, "text/plain", "Open Setup to update firmware.");
  });
  server.on("/api/status", HTTP_GET, []() {
    bool connected = WiFi.status() == WL_CONNECTED && WiFi.localIP().isSet();
    String body = "{\"name\":\"anden-dcc\",\"version\":" + jsonString(VERSION);
    body += ",\"dccImplemented\":true,\"trackPower\":false,\"dcc\":" + dccStatus();
    body += ",\"connected\":";
    body += connected ? "true" : "false";
    body += ",\"mdnsReady\":"; body += mdnsReady ? "true" : "false";
    body += ",\"storageReady\":"; body += storageReady ? "true" : "false";
    body += ",\"ssid\":" + jsonString(networkName);
    body += ",\"ip\":" + jsonString(connected ? WiFi.localIP().toString() : "");
    body += "}";
    server.sendHeader("Cache-Control", "no-store");
    server.send(200, "application/json", body);
  });
  server.on("/finder/start", HTTP_POST, []() {
    serviceFinder();
    int lo=number(server.arg("first"),127), hi=number(server.arg("last"),127);
    if(lo<0 || hi<0 || lo>hi) {server.send(400,"text/plain","Choose an ordered short-address range within 1-127. Address 0 is excluded.");return;}
    if(finderLocked()) return;
    if(!DccSignal::ready()) {server.send(503,"text/plain","Signal generator unavailable.");return;}
    finder.start(lo,hi,millis());DccSignal::setFinder(finder);
    server.send(200,"application/json",dccStatus());
  });
  server.on("/finder/answer", HTTP_POST, []() {
    serviceFinder();
    String answer=server.arg("answer");
    if(answer!="on" && answer!="off" && answer!="retry") {server.send(400,"text/plain","Answer on, off or retry.");return;}
    if(server.arg("step")!=String(finder.step) || !finder.active() || finder.wait(millis())) {
      server.send(409,"text/plain","Search changed or still settling. Refresh and try again.");return;
    }
    bool ok=answer=="retry" ? finder.retry(finder.step,millis()) : finder.answer(answer=="on",finder.step,millis());
    if(!ok) {server.send(409,"text/plain","No question is pending.");return;}
    DccSignal::setFinder(finder);server.send(200,"application/json",dccStatus());
  });
  server.on("/finder/cancel", HTTP_POST, []() {
    serviceFinder();
    // Require the displayed step so a stale tab cannot cancel a newer search.
    if(server.arg("step")!=String(finder.step)) {server.send(409,"text/plain","Search changed. Refresh first.");return;}
    if(finder.active() && finder.stage!=AddressFinder::Stage::Cleanup) {
      finder.cancel(millis());DccSignal::setFinder(finder);
    } else if(!finder.active()) finder.dismiss();
    server.send(200,"application/json",dccStatus());
  });
  server.on("/dcc/f0", HTTP_POST, []() {
    if(finderLocked()) return;
    int address = number(server.arg("address"), 127);
    String value = server.arg("on");
    if (address < 0 || (value != "0" && value != "1")) {
      server.send(400, "text/plain", "Address must be 1-127. F0 must be 0 or 1."); return;
    }
    int index = roster.findAddress(address);
    if (index < 0) { server.send(404, "text/plain", "Add this locomotive to the roster first."); return; }
    LocoRoster changed = roster;
    changed.entries[index].f0 = value == "1";
    if (!DccSignal::setRoster(changed, true)) {
      server.send(503, "text/plain", "Signal generator unavailable."); return;
    }
    roster = changed;
    server.send(200, "application/json", dccStatus());
  });
  server.on("/locos/save", HTTP_POST, []() {
    if(finderLocked()) return;
    int id = server.arg("id").length() ? number(server.arg("id"), LocoRoster::CAPACITY) : 0;
    int address = number(server.arg("address"), 127);
    String name = server.arg("name"); name.trim();
    if (id < 0 || address < 0) { server.send(400, "text/plain", "Invalid locomotive ID or address."); return; }
    LocoRoster changed = roster;
    String type=server.arg("type");
    auto result = changed.save(id, address, name.c_str(),server.hasArg("type")?type.c_str():nullptr);
    if (result != LocoRoster::Result::Ok) {
      int code = result == LocoRoster::Result::Missing ? 404 :
          result == LocoRoster::Result::Invalid ? 400 : 409;
      server.send(code, "text/plain", "Invalid name/type, duplicate address, missing locomotive or full roster."); return;
    }
    if (!saveRoster(changed)) { server.send(500, "text/plain", "Could not save locomotive settings."); return; }
    roster = changed;
    DccSignal::setRoster(roster);
    server.send(200, "application/json", dccStatus());
  });
  server.on("/locos/remove", HTTP_POST, []() {
    if(finderLocked()) return;
    int id = number(server.arg("id"), LocoRoster::CAPACITY);
    if (id < 0) { server.send(400, "text/plain", "Invalid locomotive ID."); return; }
    LocoRoster changed = roster;
    if (!changed.remove(id)) { server.send(404, "text/plain", "Locomotive not found."); return; }
    if (!saveRoster(changed)) { server.send(500, "text/plain", "Could not save locomotive settings."); return; }
    roster = changed;
    DccSignal::setRoster(roster);
    server.send(200, "application/json", dccStatus());
  });
  server.on("/wifi/save", HTTP_POST, []() {
    String ssid = server.arg("ssid"), password = server.arg("password");
    if (!ssid.length() || ssid.length() > 32 || password.length() > 63 ||
        (password.length() && password.length() < 8) ||
        ssid.indexOf('\n') >= 0 || ssid.indexOf('\r') >= 0 ||
        password.indexOf('\n') >= 0 || password.indexOf('\r') >= 0) {
      server.send(400, "text/plain; charset=utf-8", "SSID must be 1–32 bytes. Password must be 8–63 bytes, or empty for an open network."); return;
    }
    if (!saveNetwork(ssid, password)) {
      server.send(500, "text/plain; charset=utf-8", "Could not save the network settings."); return;
    }
    networkName = ssid; networkPassword = password; connectPending = true;
    server.send(200, "text/plain; charset=utf-8", "Network saved. Connecting. When anden-dcc disappears, open the assigned IP from your network.");
  });
  server.on("/wifi/forget", HTTP_POST, []() {
    if (!storageReady || (LittleFS.exists("/wifi.cfg") && !LittleFS.remove("/wifi.cfg"))) {
      server.send(500, "text/plain; charset=utf-8", "Could not erase the network settings."); return;
    }
    networkName = ""; networkPassword = ""; connectPending = false;
    stopMdns();
    WiFi.disconnect(); WiFi.mode(WIFI_AP_STA);
    if (!accessPointRunning) accessPointRunning = WiFi.softAP(AP_NAME);
    server.send(200, "text/plain; charset=utf-8", "Network forgotten. Connect to anden-dcc to configure it again.");
  });
  updater.setup(&server, "/update");
  server.begin();
  printStatus();
}

void loop() {
  serviceFinder();
  server.handleClient();
  bool connected = WiFi.status() == WL_CONNECTED && WiFi.localIP().isSet();
  // Web requests briefly interrupt the steady connected LED. The normal
  // disconnected heartbeat resumes after the same non-blocking activity pulse.
  if (webActivity && uint32_t(millis() - lastWebActivity) >= WEB_BLINK_MS) webActivity = false;
  bool desiredLed = !webActivity && (connected || ((millis() / 500) % 2 == 0));
  if (desiredLed != ledOn) {
    ledOn = desiredLed;
    digitalWrite(LED_BUILTIN, ledOn ? HIGH : LOW);
  }
  if (connected != wasConnected) {
    stopMdns();
    mdnsAttempt = millis();
    // Use the radio exclusively for the router once DHCP has completed.
    if (connected && accessPointRunning) {
      WiFi.disconnectAP();
      WiFi.mode(WIFI_STA);
      accessPointRunning = false;
    }
    printStatus(); wasConnected = connected;
  }
  if (networkName.length() && (connectPending || (!connected && uint32_t(millis()-lastAttempt) >= 30000))) {
    stopMdns();
    connectPending = false; lastAttempt = millis();
    if (!accessPointRunning) {
      WiFi.mode(WIFI_AP_STA);
      accessPointRunning = WiFi.softAP(AP_NAME);
    }
    WiFi.mode(WIFI_AP_STA);
    WiFi.beginNoBlock(networkName.c_str(), networkPassword.length() ? networkPassword.c_str() : nullptr);
    // Core 6.3.1 changes its mode flag in beginNoBlock; retain AP during retries.
    WiFi.mode(WIFI_AP_STA);
  }
  if (connected && !connectPending && !accessPointRunning && !mdnsReady &&
      uint32_t(millis() - mdnsAttempt) >= 1000) {
    mdnsAttempt = millis();
    startMdns();
    printStatus();
  }
  if (mdnsReady) MDNS.update();
  if (Serial.available() && Serial.read() == 's') printStatus();
  delay(1);
}
