laullon/anden-dcc/firmware/uno-stack-test/CabControl.cpp

#include "CabControl.h"
#include "UnoDcc.h"
#include <Arduino.h>
#include <string.h>

namespace {
constexpr uint8_t ENCODER_A = 4, ENCODER_B = 5, SELECT = 6, STOP = 2;
constexpr uint16_t RELEASE_MS = 25, MAX_MOVE_MS = 800;

uint8_t readPhase() {
  return (digitalRead(ENCODER_A) ? 2 : 0) | (digitalRead(ENCODER_B) ? 1 : 0);
}
} // namespace

void CabControl::begin() {
  pinMode(ENCODER_A, INPUT_PULLUP);
  pinMode(ENCODER_B, INPUT_PULLUP);
  pinMode(SELECT, INPUT_PULLUP);
  pinMode(STOP, INPUT_PULLUP);
  phase = readPhase();
  selectLatched = digitalRead(SELECT) == LOW;
  selectLowAt = millis();
}

void CabControl::roster(uint8_t size, const uint8_t* values, uint8_t cabMask) {
  count = 0;
  memset(names, 0, sizeof(names));
  uint8_t next = 0;
  for (uint8_t i = 0; i < size; ++i) {
    if (!(cabMask & (1 << i)))
      continue;
    addresses[count++] = values[i];
    if (!next || values[i] == selected)
      next = values[i];
  }
  selected = next;
  transitions = 0;
}

void CabControl::clearRoster() {
  count = speed = 0;
  transitions = 0;
}

uint8_t CabControl::address() const {
  return count ? selected : 0;
}

uint8_t CabControl::step() const {
  return speed;
}

const char* CabControl::name() const {
  for (uint8_t i = 0; i < count; ++i)
    if (addresses[i] == selected)
      return names[i];
  return "";
}

bool CabControl::setName(uint8_t address, const char* hex) {
  for (uint8_t i = 0; i < count; ++i)
    if (addresses[i] == address)
      return CabLabel::decode(names[i], hex);
  return false;
}

bool CabControl::stop() {
  if (!speed)
    return true;
  speed = 0;
  transitions = 0;
  return UnoDcc::motion(selected, 1);
}

bool CabControl::poll(bool trackPowered) {
  const uint32_t now = millis();
  const uint8_t current = readPhase();
  const uint8_t previous = phase;
  phase = current;

  if (digitalRead(STOP) == LOW) {
    stopLowAt = now;
    transitions = 0;
    if (!stopLatched) {
      stopLatched = true;
      // The same broadcast stop burst used at track startup stops all addresses.
      if (trackPowered)
        UnoDcc::startStopped();
      return stop();
    }
    return true;
  }
  if (stopLatched) {
    if (uint32_t(now - stopLowAt) >= RELEASE_MS)
      stopLatched = false;
    return true;
  }

  if (speed && (!trackPowered || uint32_t(now - motionStarted) >= MAX_MOVE_MS))
    return stop();

  if (digitalRead(SELECT) == LOW) {
    selectLowAt = now;
    transitions = 0;
    if (!selectLatched) {
      selectLatched = true;
      if (!stop())
        return false;
      for (uint8_t i = 0; i < count; ++i) {
        if (addresses[i] == selected) {
          selected = addresses[(i + 1) % count];
          break;
        }
      }
    }
    return true;
  }
  if (selectLatched) {
    if (uint32_t(now - selectLowAt) >= RELEASE_MS)
      selectLatched = false;
    return true;
  }
  if (!trackPowered || !count) {
    transitions = 0;
    return true;
  }
  if (current == previous)
    return true;
  if ((current ^ previous) == 3) {
    transitions = 0;
    return true;
  }

  // Count a whole quadrature cycle so contact bounce does not add speed.
  const uint8_t clockwise[] = {1, 3, 0, 2};
  transitions += clockwise[previous] == current ? 1 : -1;
  if (transitions > -4 && transitions < 4)
    return true;

  const int next = int(speed) + (transitions > 0 ? 1 : -1);
  transitions = 0;
  if (next < 0 || next > UnoDcc::MAX_CRAWL_STEP)
    return true;
  if (!UnoDcc::motion(selected, next ? next + 1 : 0))
    return false;
  if (!speed && next)
    motionStarted = now;
  speed = next;
  return true;
}
