laullon/anden-dcc/firmware/uno-stack-test/BridgeBench.h

#pragma once
#include <stdint.h>

// Bench pulses and stationary track control. The ADC limit remains uncalibrated.
class BridgeBench {
public:
  static constexpr uint16_t DURATION_MS = 3000, RAW_LIMIT = 100;
  // State and mode numbers are carried in the UART STATE reply.
  enum State : uint8_t {
    Idle,
    Running,
    Complete,
    Stopped,
    RawTrip,
    TimingFault,
    GuardExpired,
    LeaseExpired
  };
  State state = Idle;
  enum Mode : uint8_t { DcReverse, DcForward, Dcc, Track };
  uint8_t mode = DcReverse;
  bool direction = false;
  bool active() const { return state == Running; }
  bool start(uint8_t requestedMode, uint32_t now, uint16_t raw, bool healthy);
  void poll(uint32_t now, uint16_t raw, bool healthy, bool guardExpired);
  uint16_t duration() const { return mode == Track ? 2000 : DURATION_MS; }
  bool renew(uint32_t now);
  void stop();
  uint16_t remaining(uint32_t now) const;

private:
  uint32_t started = 0;
};

// Main arms/disarms with interrupts masked. Timer1 calls tick() each half-bit.
// 60,000 halves last 3.48–6 seconds at the fixed 58/100 us timings, providing
// a second cutoff if the main loop stops servicing the bench or track deadline.
class BridgeGuard {
public:
  static constexpr uint16_t HALVES = 60000;
  volatile bool expired = false;
  void arm() {
    remaining = HALVES;
    expired = false;
  }
  void disarm() { remaining = 0; }
  bool tick() {
    if (remaining && !--remaining) {
      expired = true;
      return true;
    }
    return false;
  }

private:
  volatile uint16_t remaining = 0;
};
static_assert(uint32_t(BridgeGuard::HALVES) * 58 > uint32_t(BridgeBench::DURATION_MS) * 1000,
              "Guard must outlast the normal pulse");
