laullon/anden-dcc/(commit log)

2026-10-29 Initial anden-dcc Wi-Fi and web OTA prototype
2026-10-29 Remove Wi-Fi and OTA authentication for local prototype
2026-10-29 Validate first Pico W deployment and fix access point address
2026-10-29 Show Wi-Fi connection state on onboard LED
2026-10-29 Restore mDNS discovery after switching to station-only Wi-Fi
2026-10-29 Blink onboard LED on HTTP activity
2026-10-29 Ignore background status polls for LED activity
2026-10-29 Prepare GitHub documentation, protected wiring proposal and BOM
2026-10-29 Drop decoder programming and simplify to a single track output
2026-10-30 Document direct Pico control with CD4077 removal guide
2026-10-30 Remove prototype numbers and use generic loco labels
2026-11-02 Record stacked Uno relay test and shared UART limitation
2026-11-02 Add and validate USB-only Uno ESP13 motor-shield bench tests
2026-11-02 Add ESP13 blue LED Wi-Fi and web-request feedback
2026-11-03 Replace the ESP13 theme dropdown with buttons
2026-11-03 Add and validate bounded motor-shield bench tests
2026-11-03 Add timed DCC scope tests through Uno motor shield
2026-11-03 Add stationary track control, direction and guided address finder
2026-11-03 Clarify track power and show directional loco lights
2026-11-03 Keep power controls stable during switching
2026-11-03 Allow editing address search range before powering track
2026-11-06 Stabilize mouse interaction and track heartbeat sessions
2026-11-06 Add F0–F28 locomotive functions and named favorites
2026-11-06 Make Uno and ESP13 the sole platform and keep power controls visible
2026-11-06 Unify function toggles and allow presets with track power off
2026-11-10 Add local encoder cab with prioritized stops and OLED readout
2026-11-10 Filter encoder selection to diorama locos and add separate STOP
2026-11-10 Illustrate encoder wiring in the cab guide
2026-11-10 Document encoder cab wiring
2026-11-11 Document cab-mounted USB-C PD and MP1584 power
2026-11-12 Show loco names and a richer throttle layout on the cab OLED
2026-11-12 Keep OLED I2C traffic from blocking Uno DCC timing
2026-11-12 Gate loco card controls on track presence
2026-11-12 Define Pico 2 W Rev A mixed-assembly hardware plan
2026-11-12 Record Pico 2 W project decisions and open design work
2026-11-12 Mark Pico 2 W hardware as an experiment for agents and readers
2026-11-12 Keep experimental Pico design in the main checkout
2026-11-12 Prepare experimental Pico 2 W KiCad project scaffold
2026-11-12 Capture USB-C PD negotiation core for schematic review
2026-11-12 Upgrade schematic files to native KiCad 10 format
2026-11-12 Simplify IC annotations and tidy schematic labels
2026-11-12 Capture protected power supply and status LEDs for Pico experiment
